gotemcoach86/Geeetech-Spark-E3/Hardware/Geeetech Spark E3 V1.0_Bottom.pdf

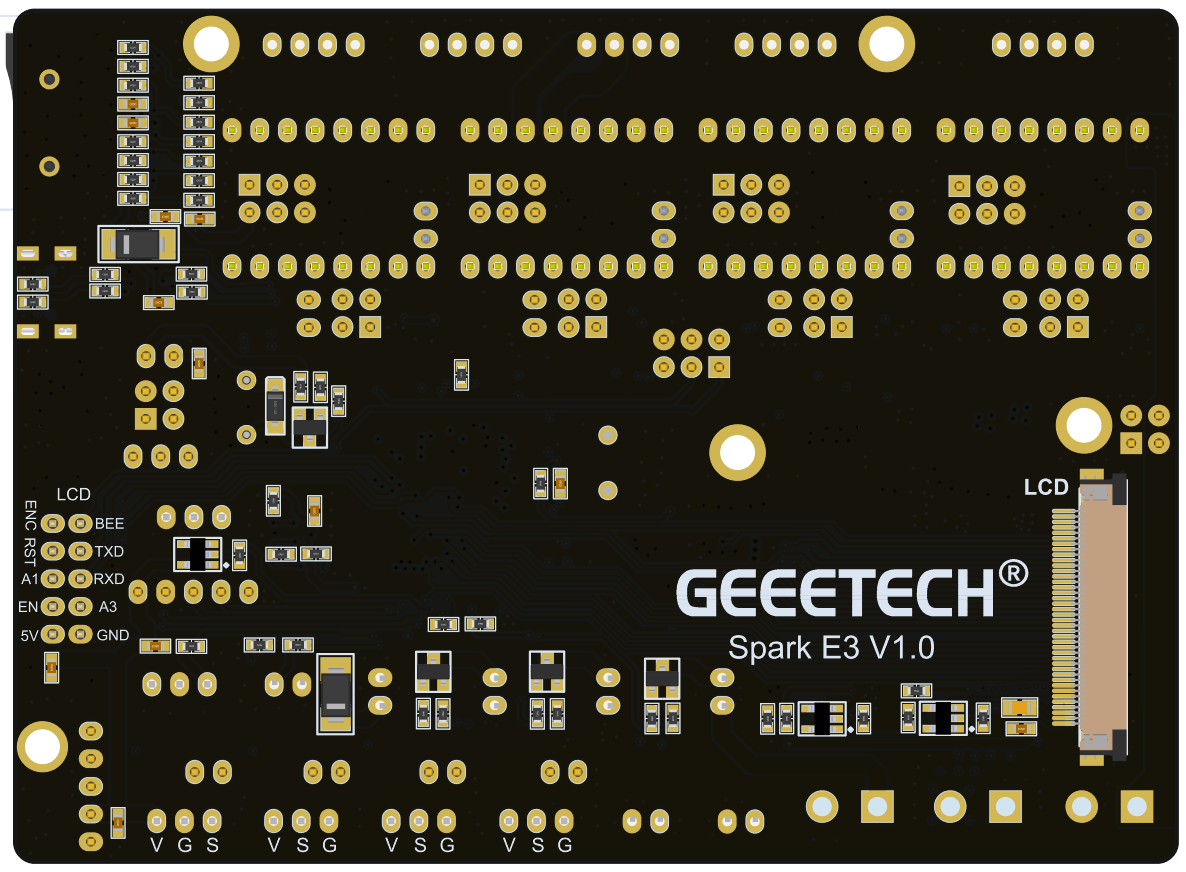
[picture p1: figure]
