gotemcoach86/Geeetech-Spark-E3/Hardware/Geeetech Spark E3 V1.0_Size.pdf

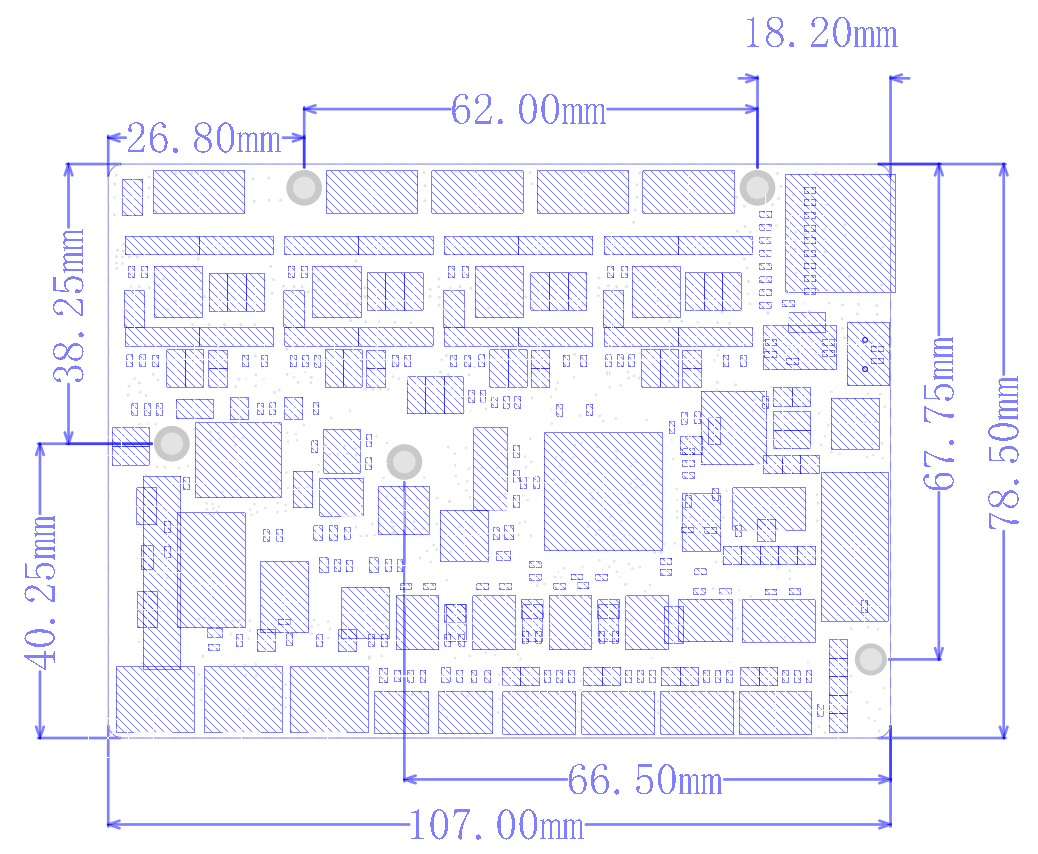
[picture p2: figure]
