gotemcoach86/Geeetech-Spark-E3/Hardware/Geeetech Spark E3 V1.0_Top.pdf

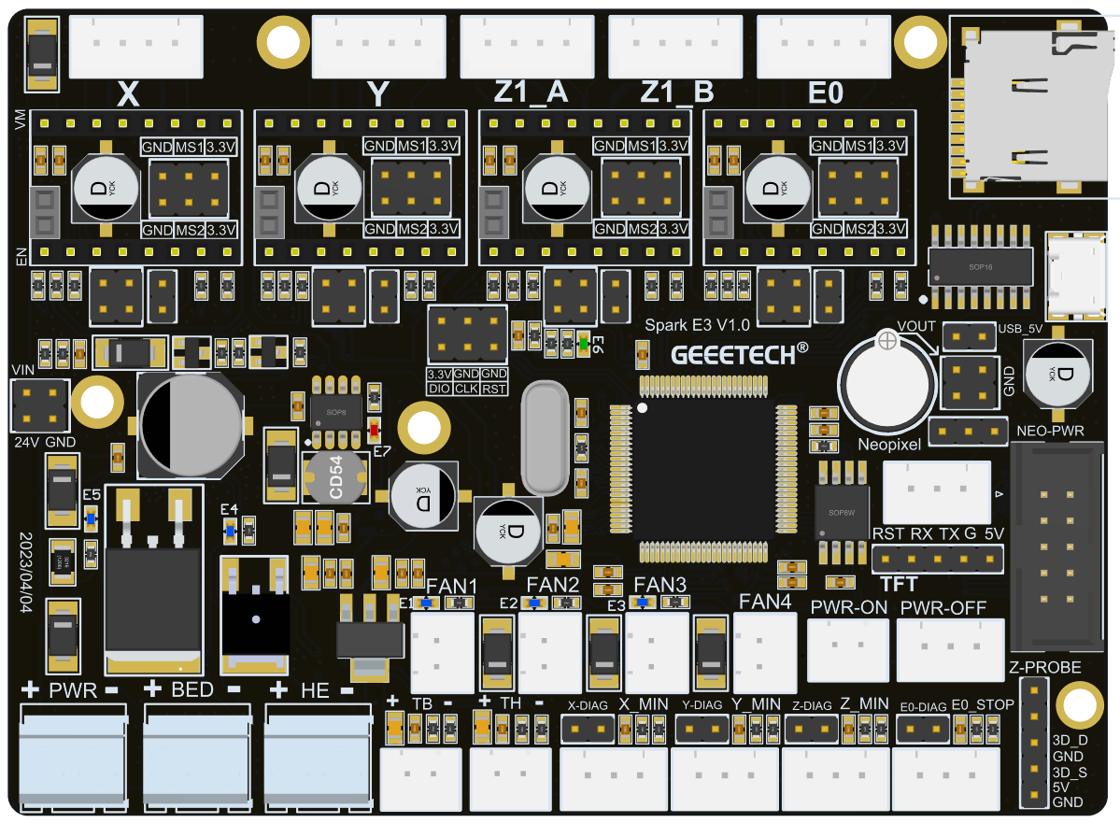
[picture p3: figure]
