gotemcoach86/Geeetech-Spark-E3/Hardware/Geeetech Spark E3 V1.0_Bottom_Designator.pdf

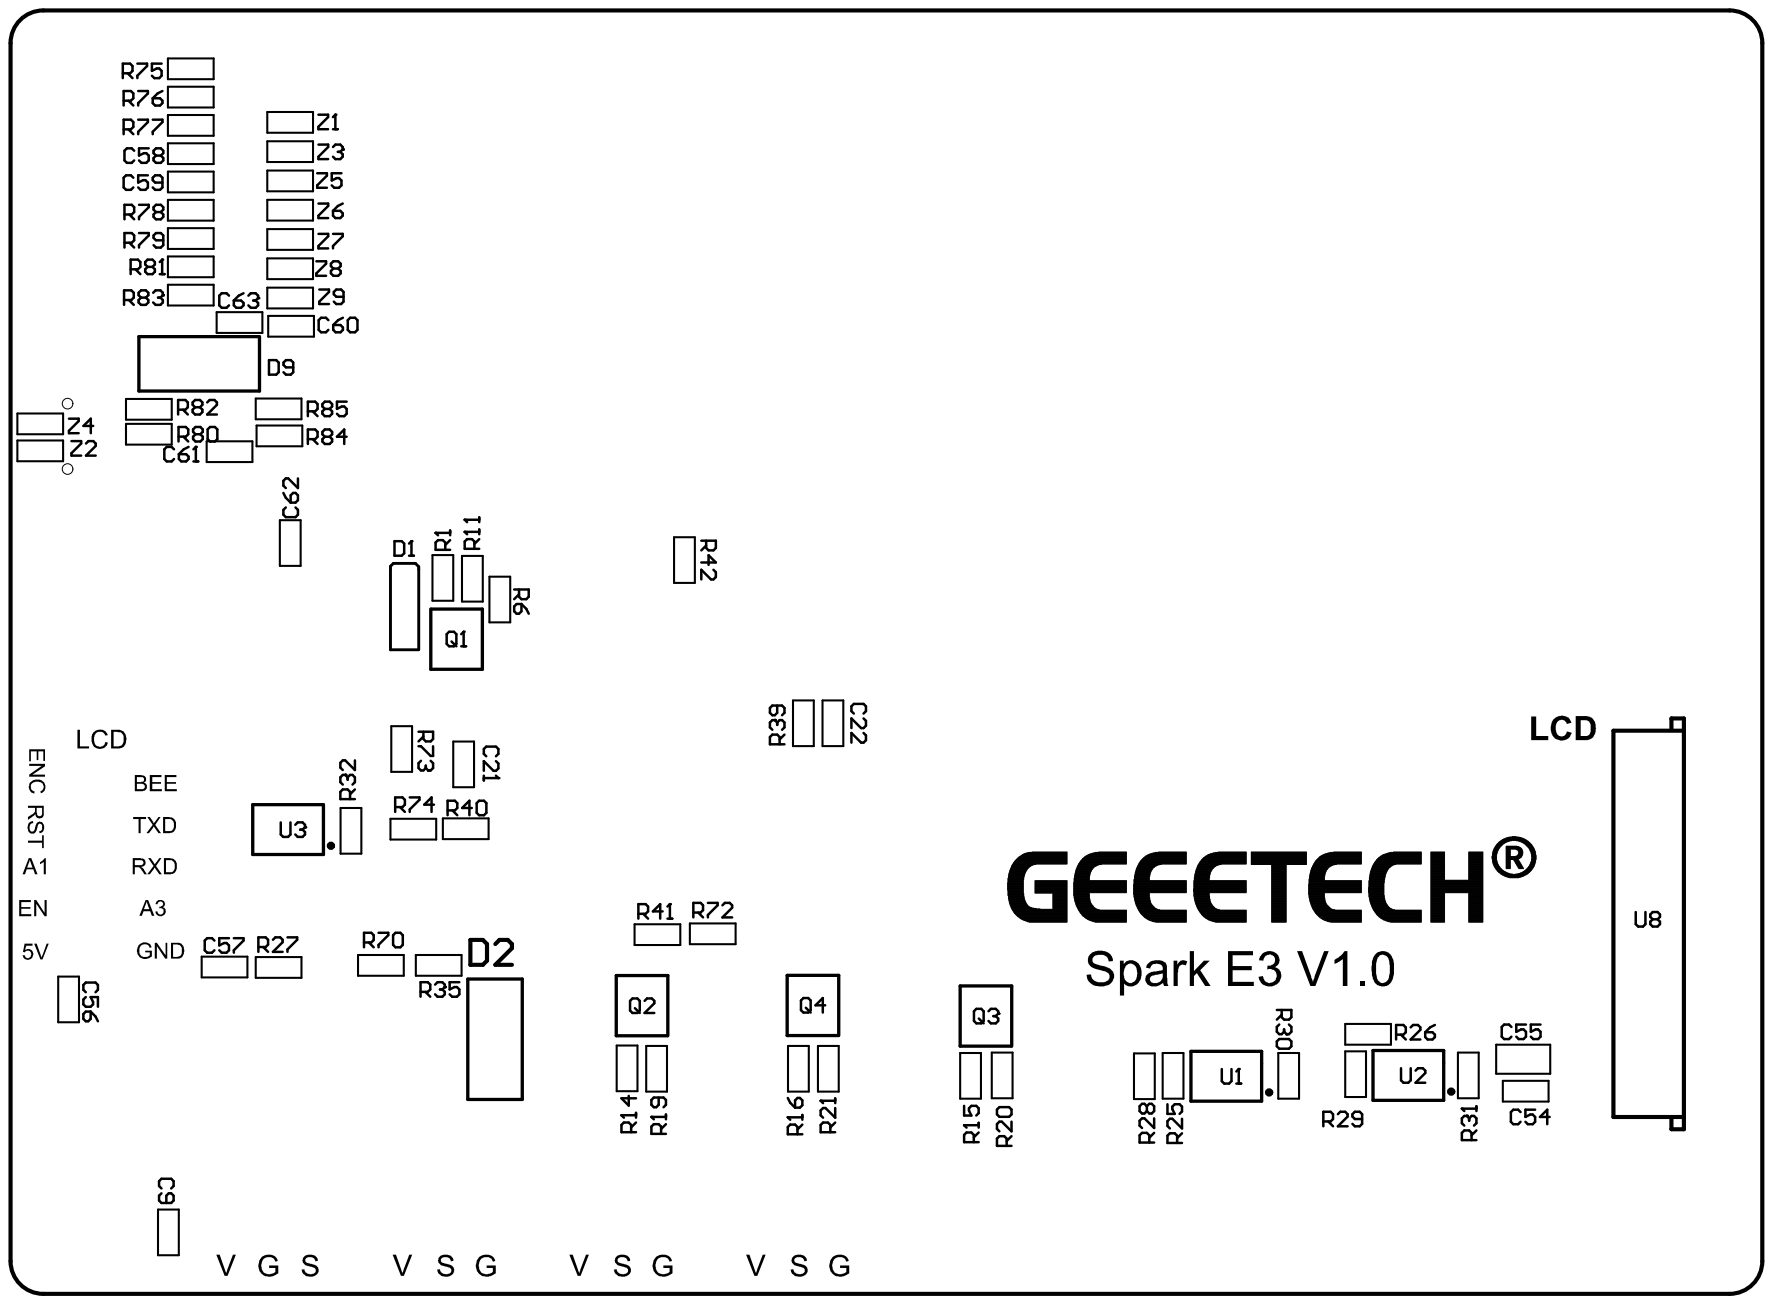
[picture p4: page 1]
