gotemcoach86/Geeetech-Spark-E3/Hardware/Geeetech Spark E3 V1.0_SCH.pdf

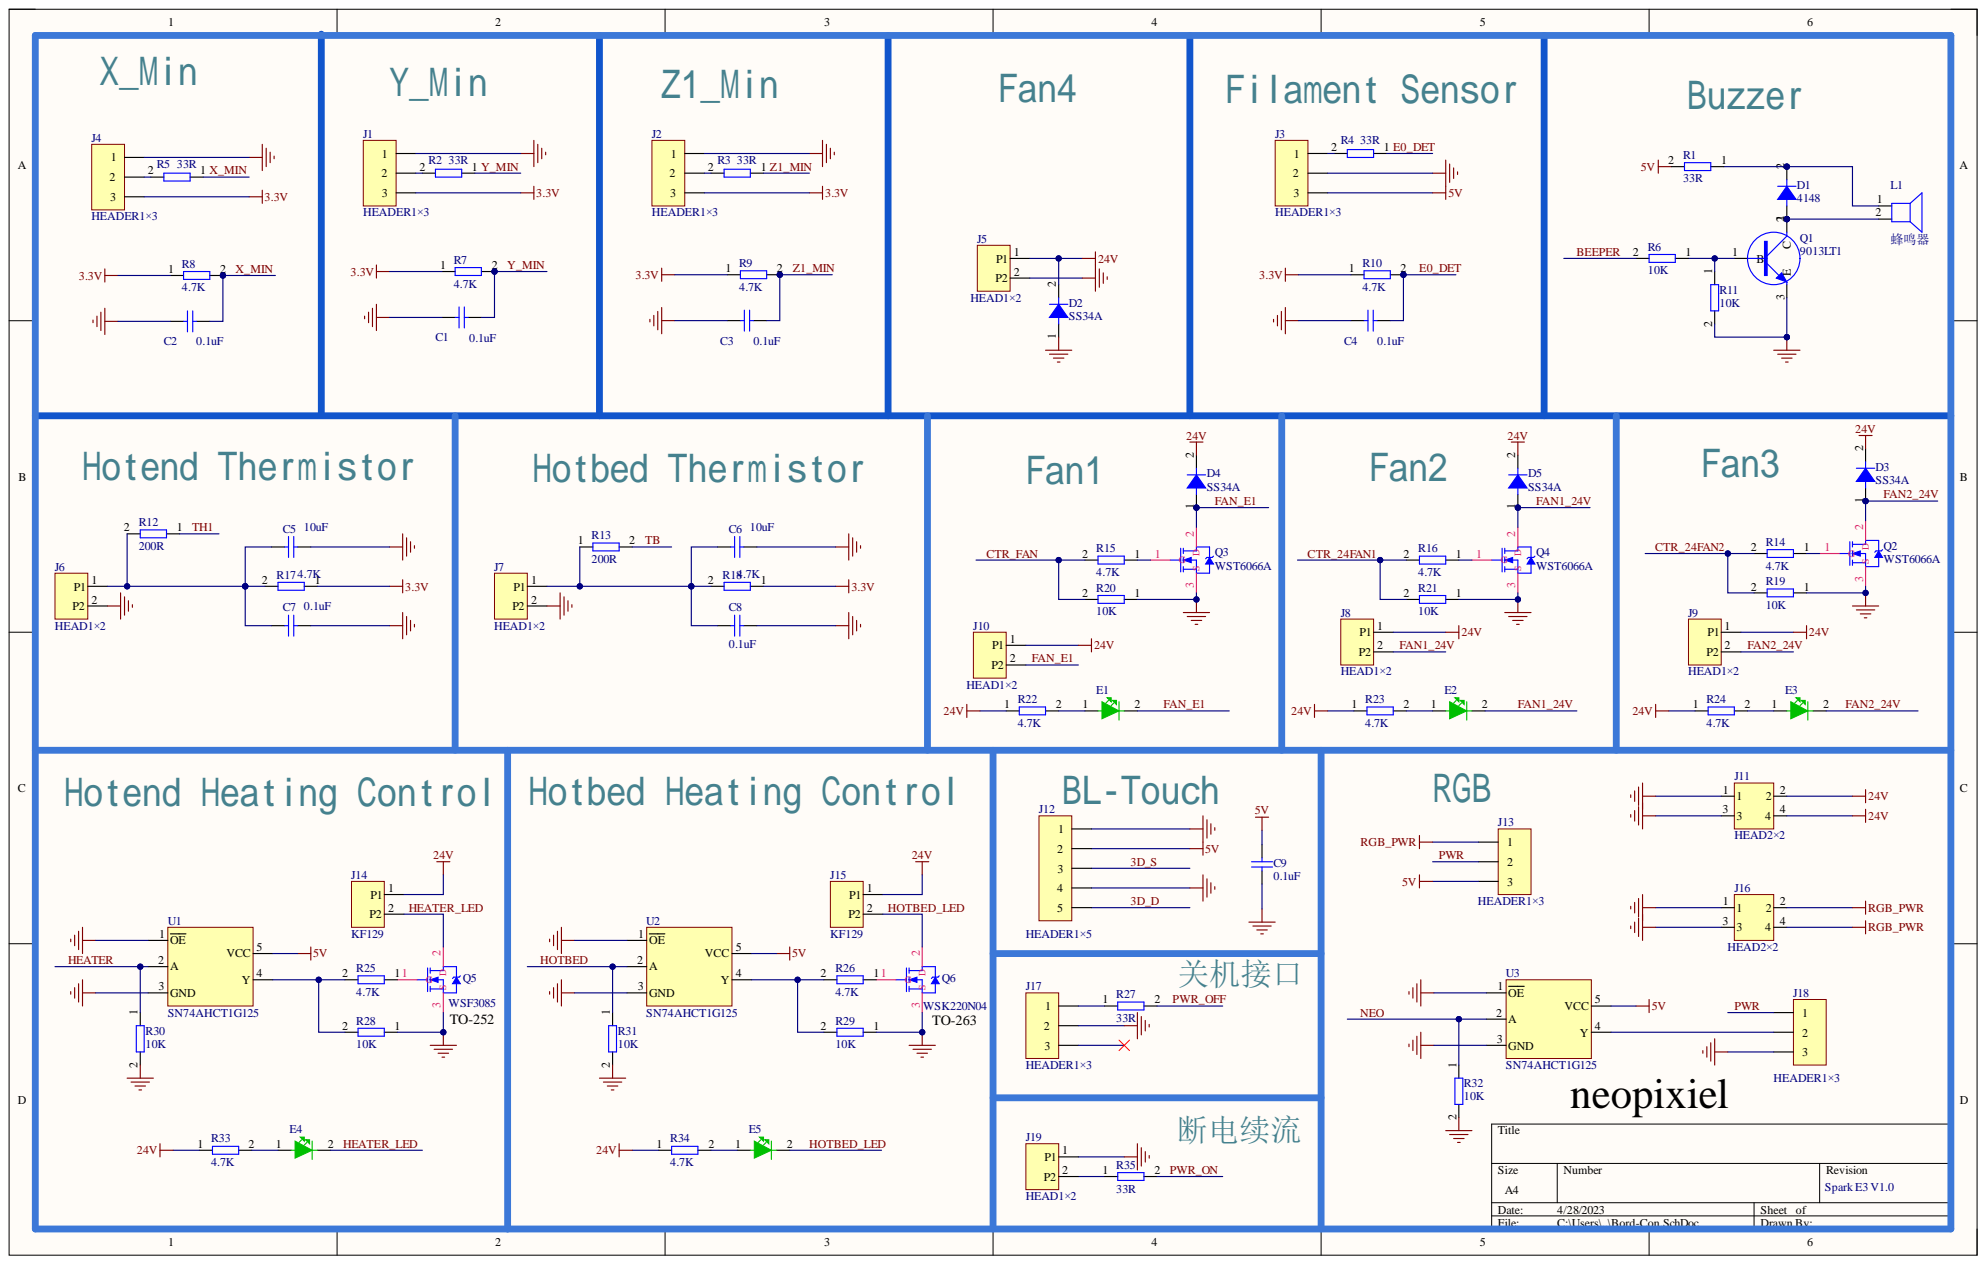
[picture p5: page 1]

Size A4 | Number | Revision Spark E3 V1.0

Date: 4/28/2023 | Sheet of
File: C:\Users\..\Bord-Con.SchDoc | Drawn By:

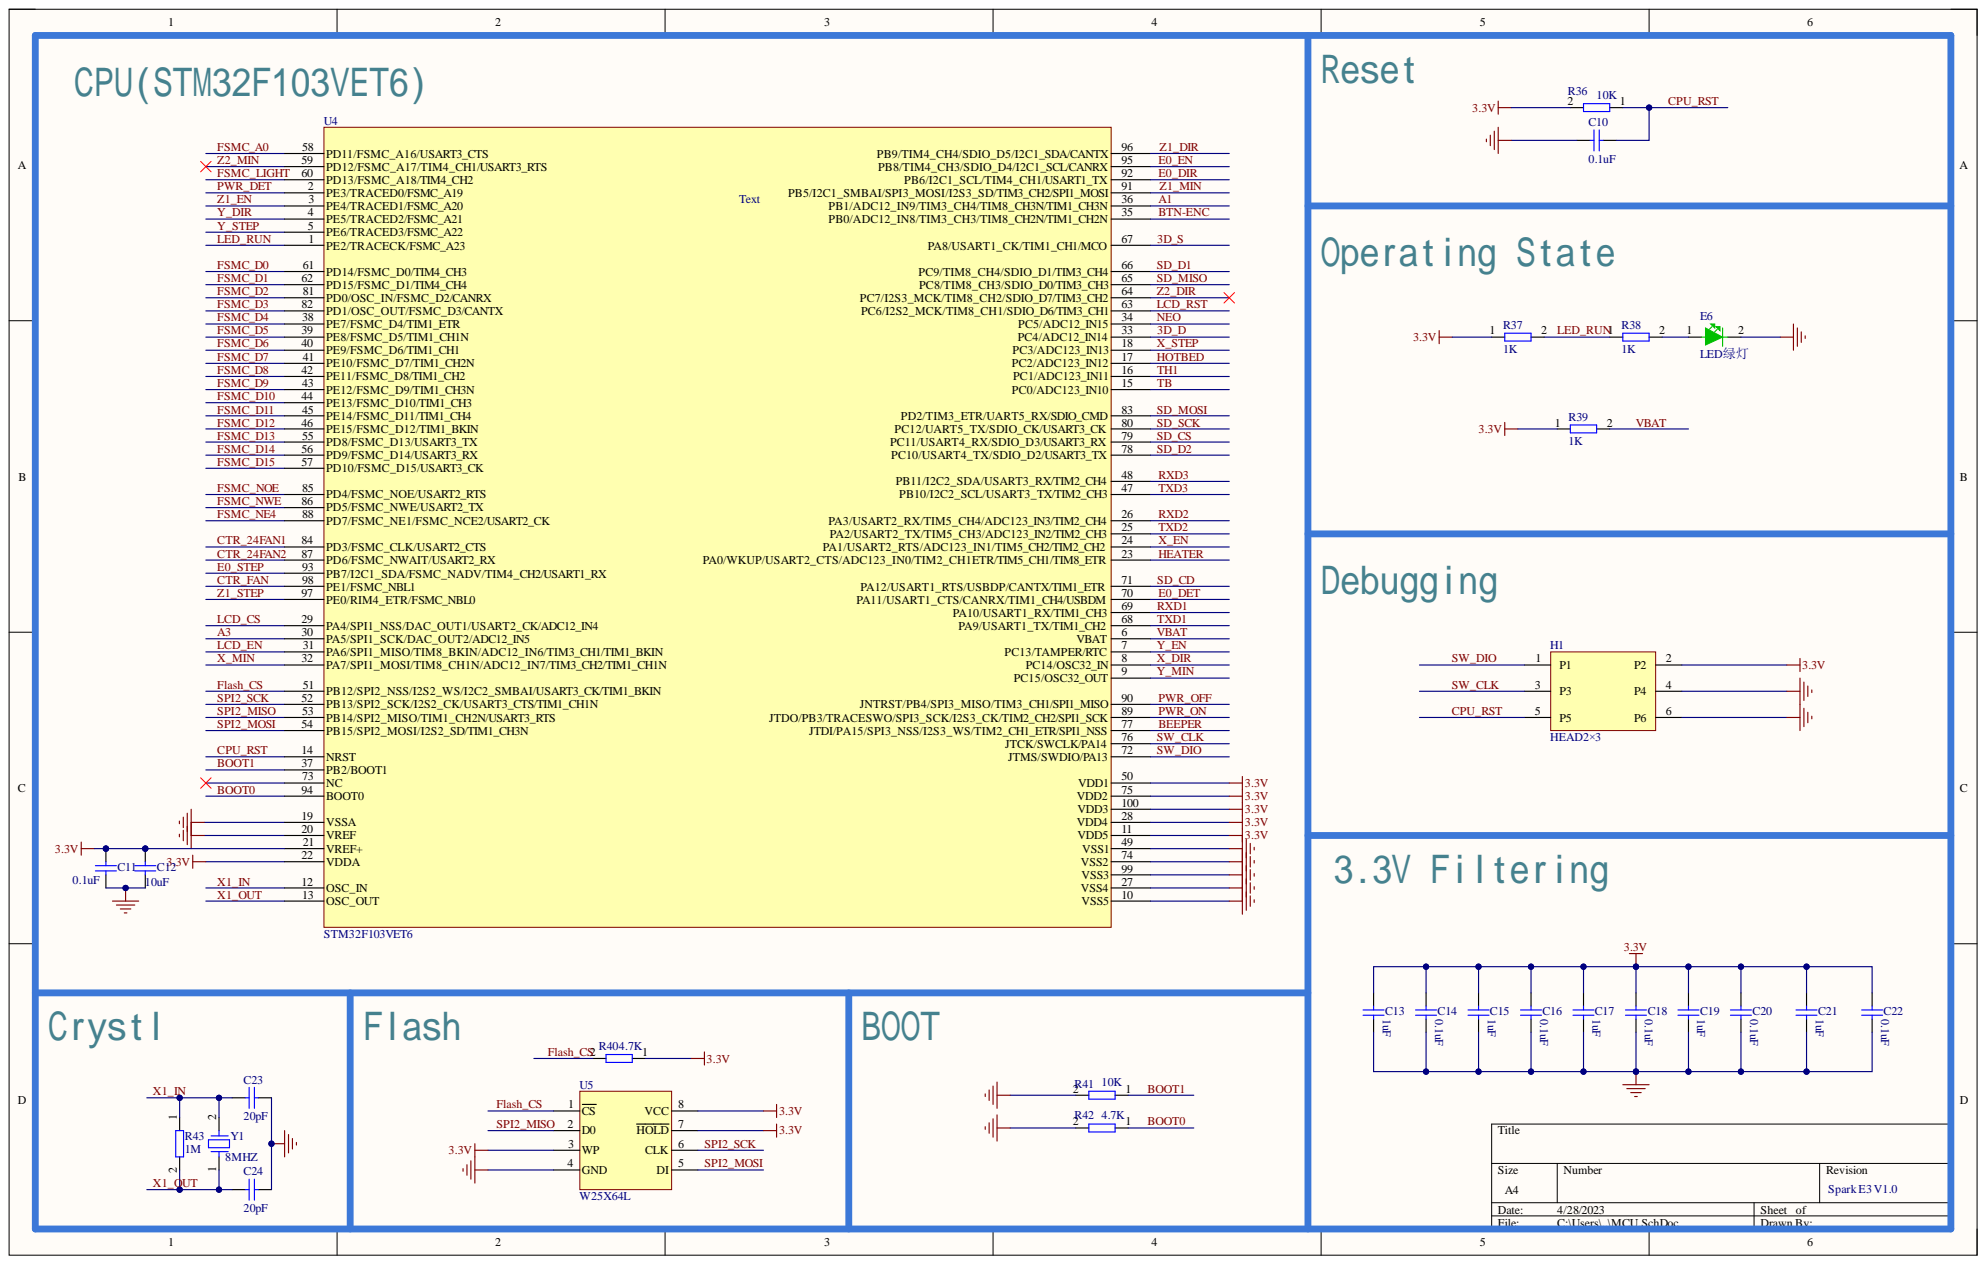
[picture p6: page 2]

Date : 4/2 8 /2 0 2 3 | S h e et o f
File : C:\Users\. .\MCU. S c h D o c | Drawn By :

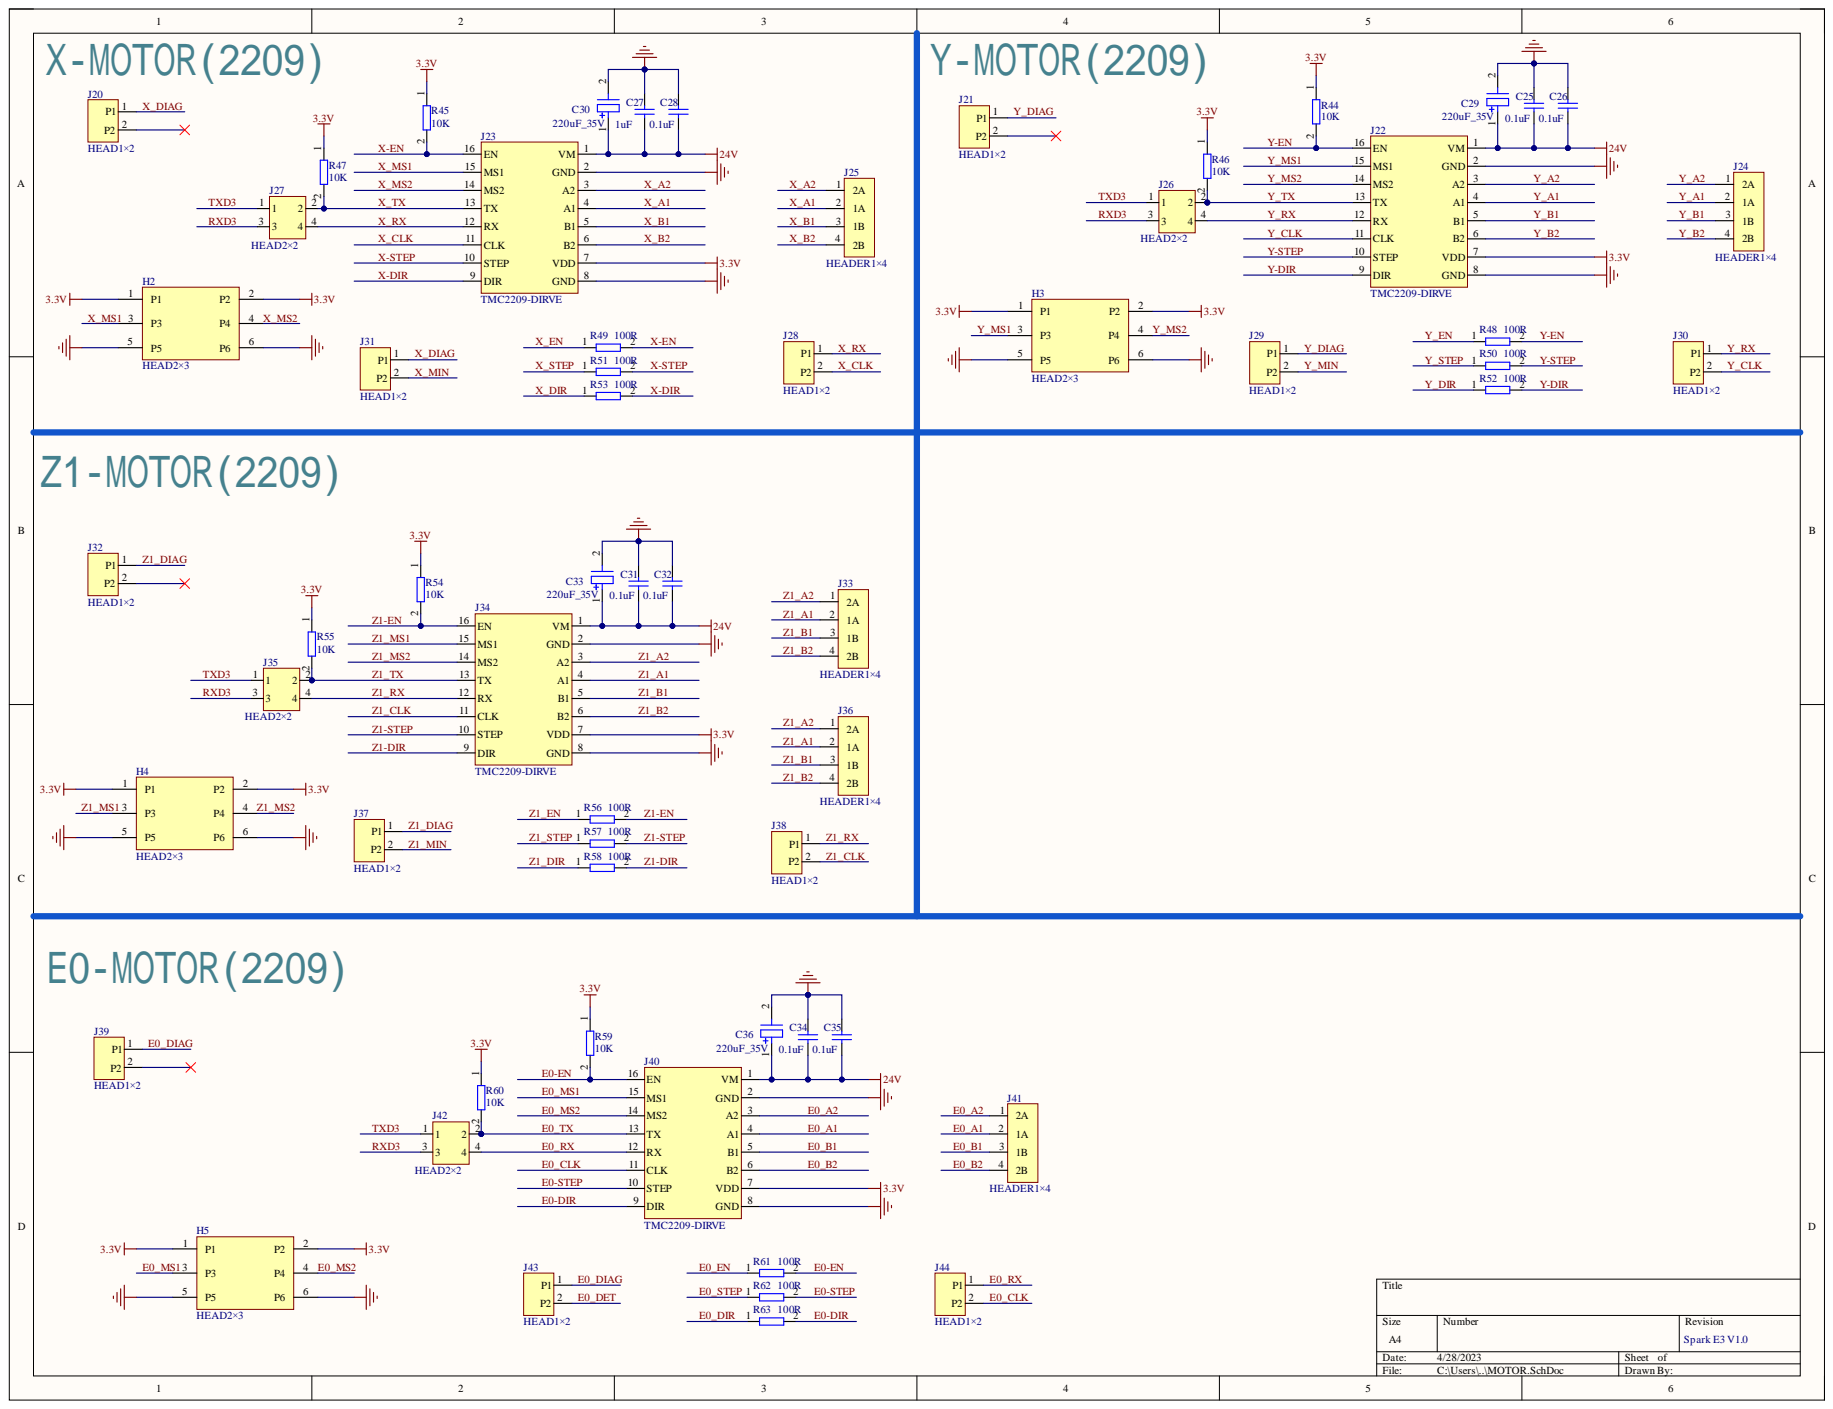
[picture p7: page 3]

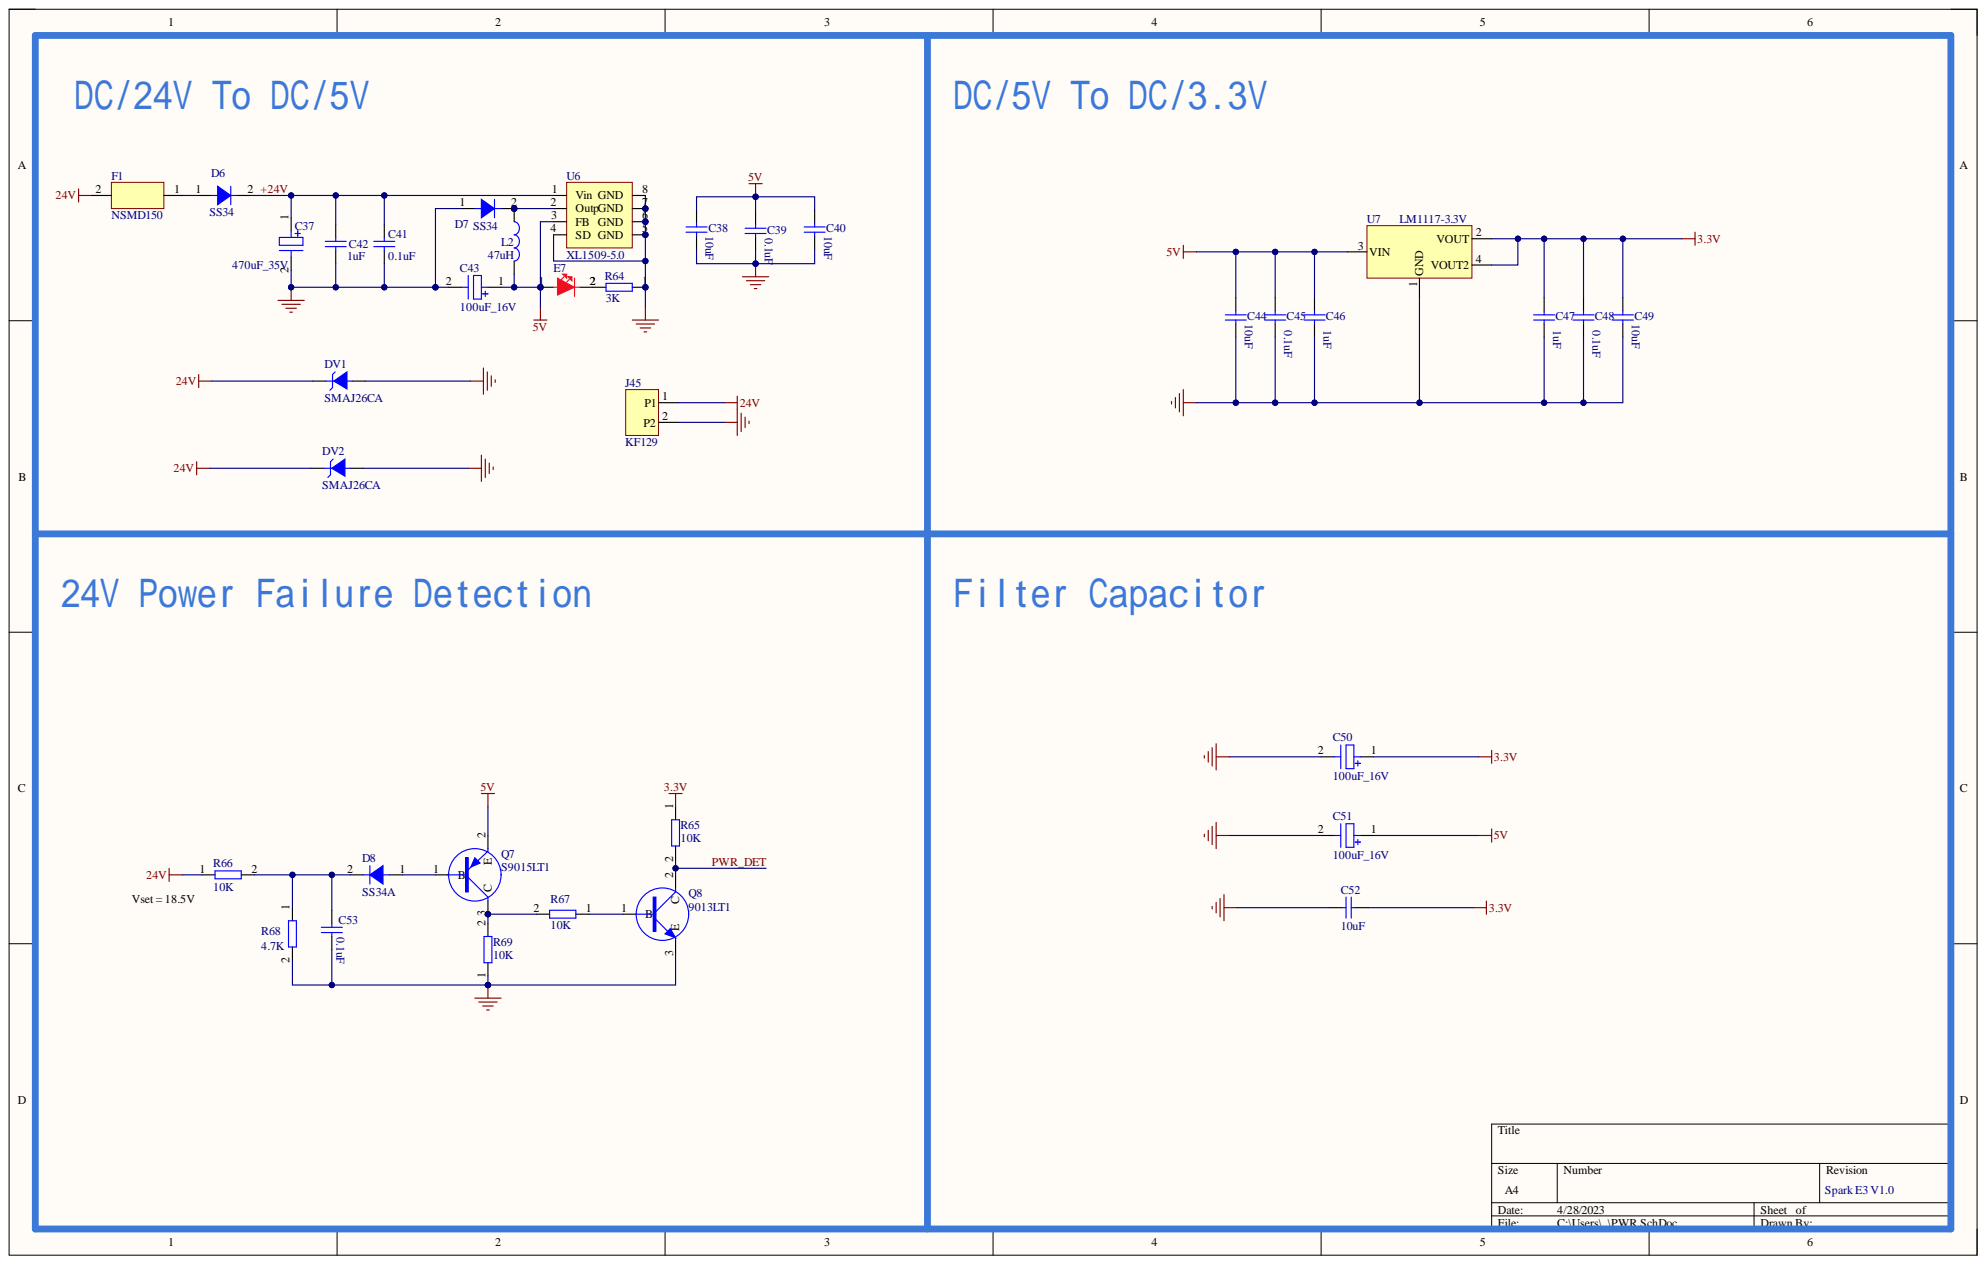
[picture p8: page 4]

Size A4 | Number | Revision Spark E3 V1.0

Date: 4/28/2023 | Sheet of
File: C:\Users\..\PWR.SchDoc | Drawn By:

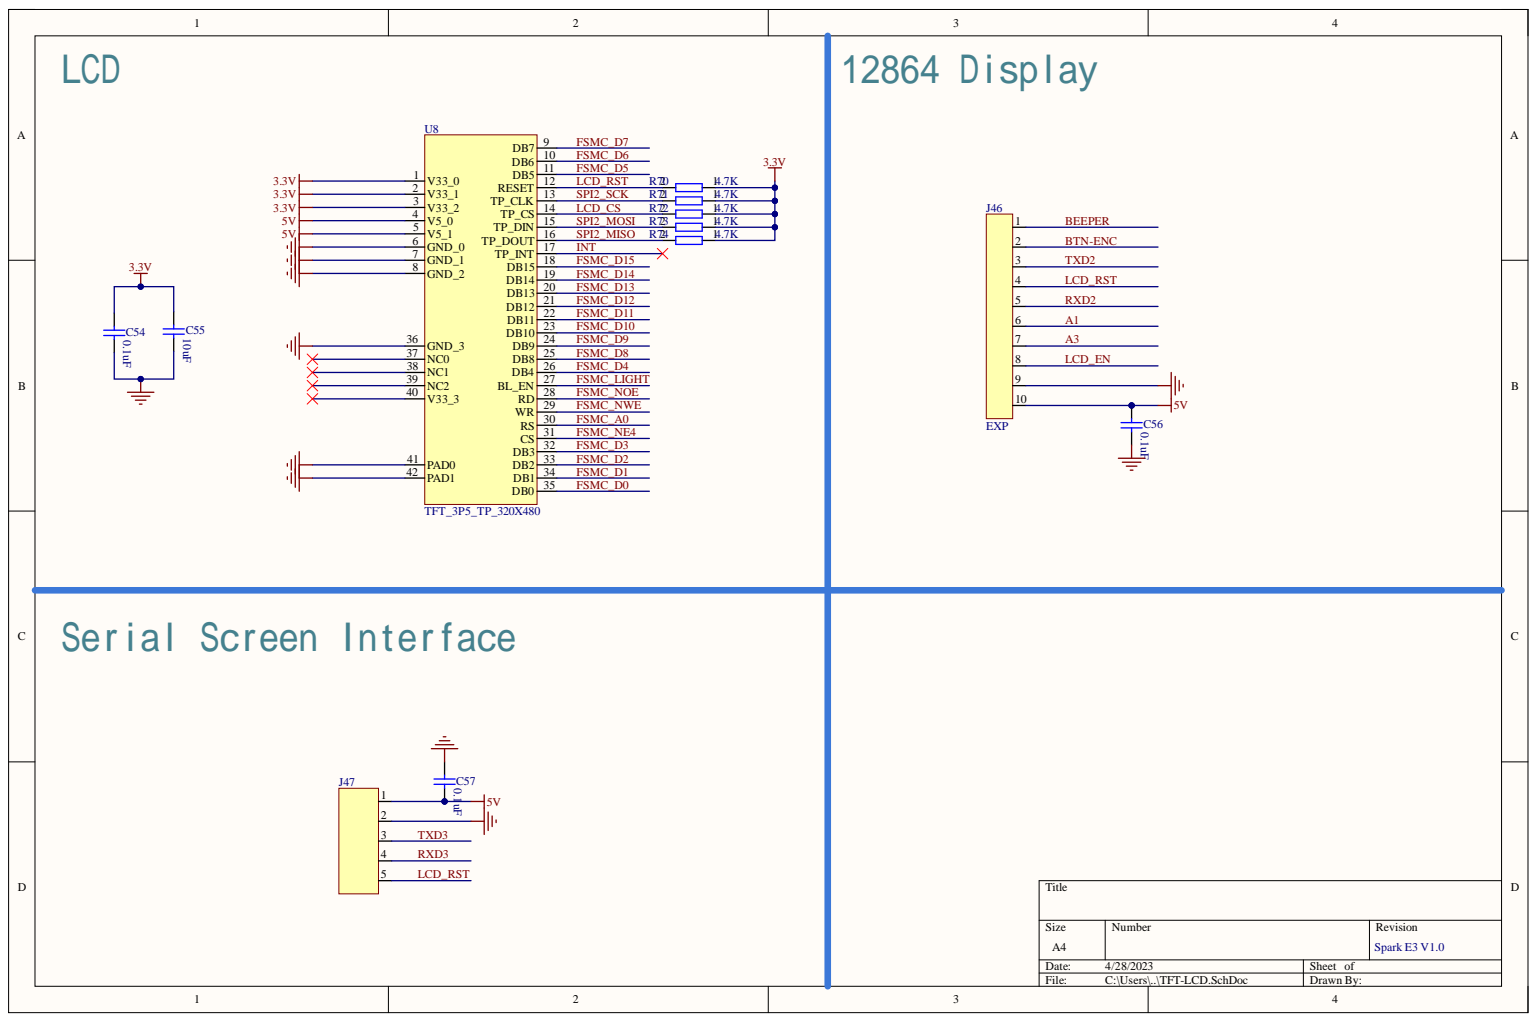
[picture p9: page 5]

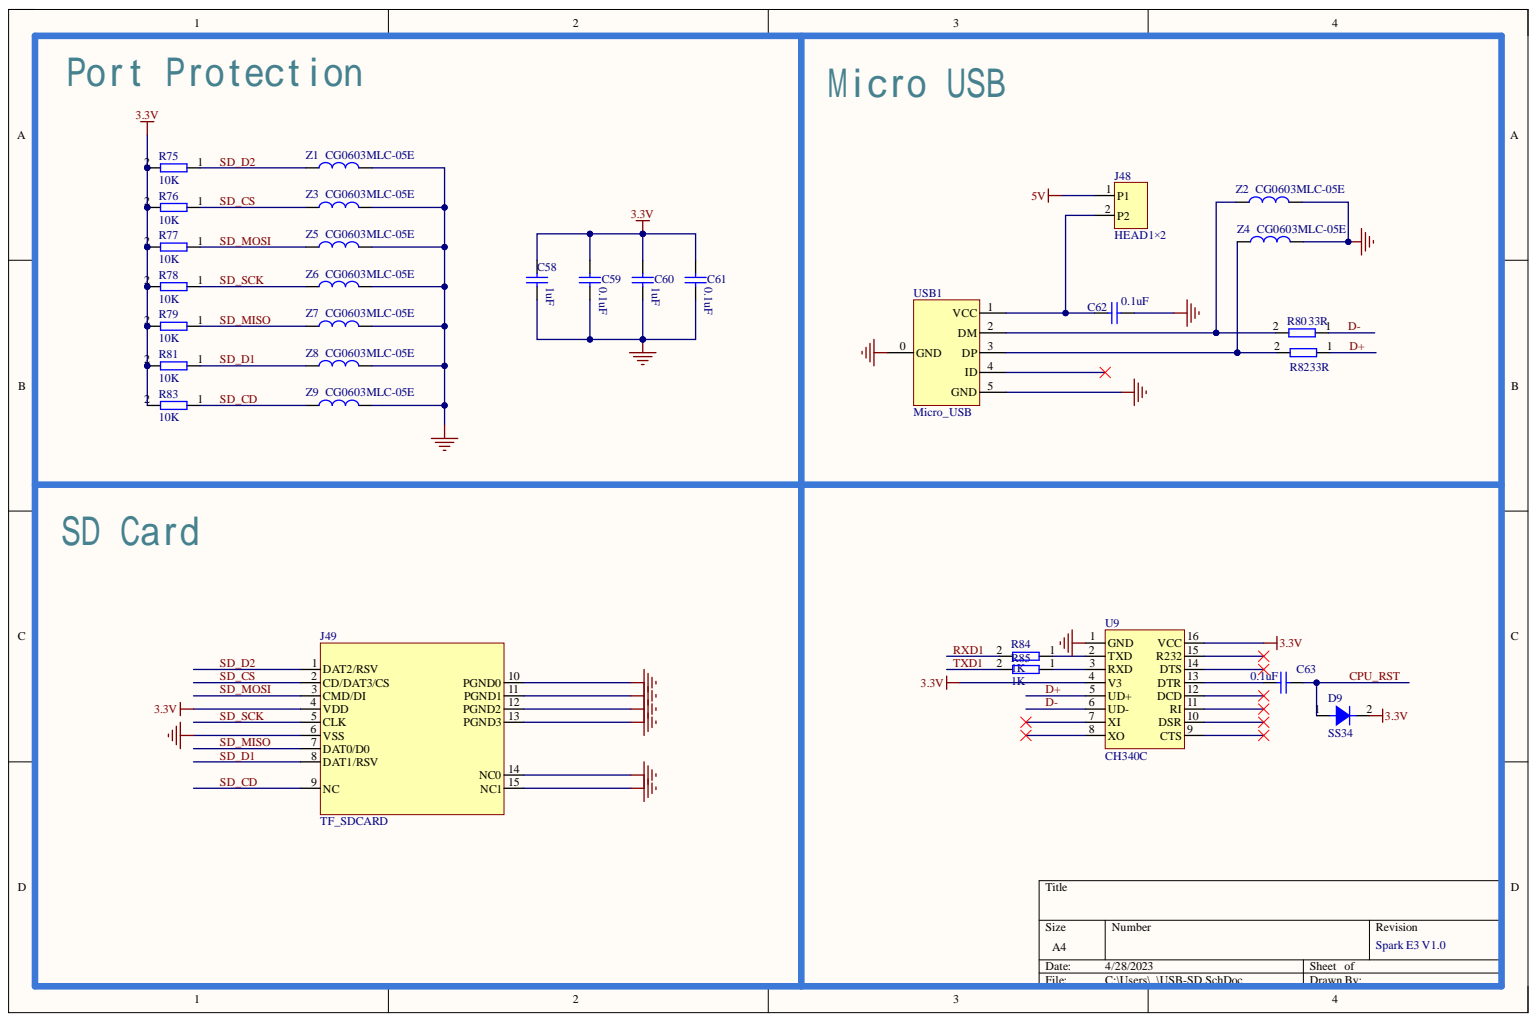
[picture p10: page 6]

Size A4 | Number | Revision Spark E3 V1.0

Date: 4/28/2023 | Sheet of
File: C:\Users\..\USB-SD.SchDoc | Drawn By:
