gotemcoach86/Geeetech-Spark-E3/Hardware/Geeetech Spark E3 V1.0_Top_Designator.pdf

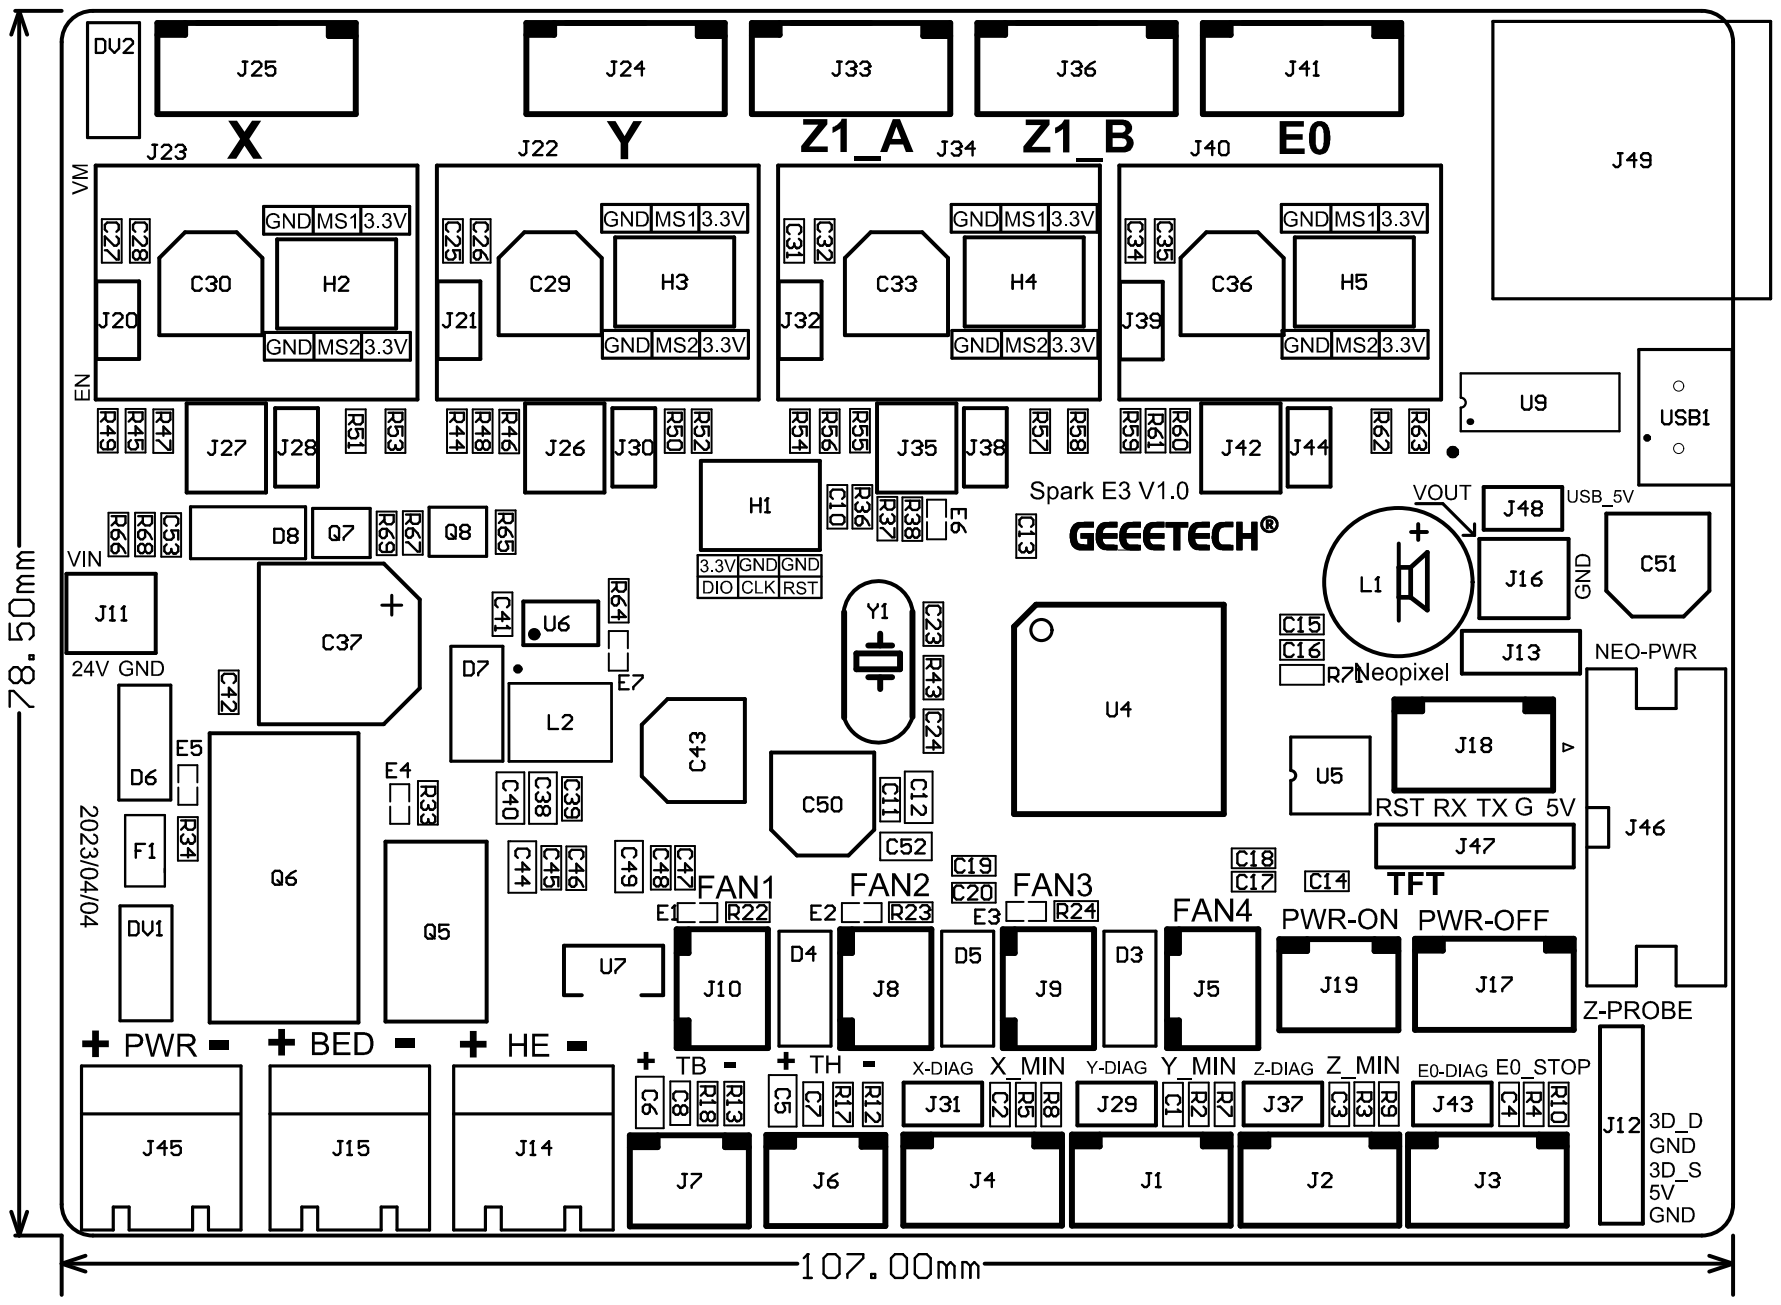
[picture p11: page 1]
