gotemcoach86/Geeetech-Spark-E3/Firmware/Marlin/SparkE3_V1.0_230428/SRC/Marlin-SparkE3-Lcd12864-A4988/Marlin/src/pins/stm32f1/pins_GTM32_SPARK_E2.h

/**
 * Marlin 3D Printer Firmware
 * Copyright (c) 2021 MarlinFirmware [https://github.com/MarlinFirmware/Marlin]
 *
 * Based on Sprinter and grbl.
 * Copyright (c) 2011 Camiel Gubbels / Erik van der Zalm
 *
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
 */
#pragma once

//
// Release PB4 (Y_ENABLE_PIN) from JTAG NRST role
//
#define DISABLE_JTAG
//
// Release PB3 PB4 PA15
//
#define DISABLE_DEBUG

#define BOARD_INFO_NAME			"Spark E3 V1.0"
#define CUSTOMER_FW_VERSION "1.0.0"

/**
 * MKS Robin Nano board common pin assignments
 */
#if HOTENDS > 2 || E_STEPPERS > 2
  #error "GTM32 Spark E2 boards support up to 2 hotends / E steppers."
#endif

#define BOARD_NO_NATIVE_USB

// Avoid conflict with TIMER_SERVO when using the STM32 HAL
#define TEMP_TIMER  5

//
// EEPROM
//
#if ENABLED(SRAM_EEPROM_EMULATION)
  #undef NO_EEPROM_SELECTED
#endif
#if EITHER(NO_EEPROM_SELECTED, FLASH_EEPROM_EMULATION)
  #define FLASH_EEPROM_EMULATION
  #define EEPROM_PAGE_SIZE     (0x800U) // 2K
  #define EEPROM_START_ADDRESS (0x8000000UL + (STM32_FLASH_SIZE) * 1024UL - (EEPROM_PAGE_SIZE) * 2UL)
  #define MARLIN_EEPROM_SIZE    EEPROM_PAGE_SIZE  // 2K
#endif

//
// Z Probe (when not Z_MIN_PIN)
//
#define Z_MIN_PROBE_PIN                     PC4

#define LED_PIN                           	PE2

#define SPI_DEVICE                          2

//
// Servos
//
#define SERVO0_PIN                          PA8   // Enable BLTOUCH

//
// Limit Switches
//
#define X_STOP_PIN                          PA7
#define Y_STOP_PIN                          PC15
#define Z_MIN_PIN                           PB5
#define Z_MAX_PIN                           PD12

//
// Steppers
//
#define X_ENABLE_PIN                        PA1
#define X_STEP_PIN                          PC3
#define X_DIR_PIN                           PC14

#define Y_ENABLE_PIN                        PC13
#define Y_STEP_PIN                          PE6
#define Y_DIR_PIN                           PE5

#define Z_ENABLE_PIN                        PE4
#define Z_STEP_PIN                          PE0
#define Z_DIR_PIN                           PB9


#define E0_ENABLE_PIN                       PB8
#define E0_STEP_PIN                         PB7
#define E0_DIR_PIN                          PB6

//
// Temperature Sensors
//
#define TEMP_0_PIN                          PC1   // TH1
#define TEMP_1_PIN                          -1    // TH2
#define TEMP_BED_PIN                        PC0   // TB1

//
// Heaters / Fans
//
#ifndef HEATER_0_PIN
  #define HEATER_0_PIN                      PA0
#endif
#ifndef FAN_PIN
  #define FAN_PIN                           PE1 // FAN
  #define FAN_SOFT_PWM
#endif
#ifndef HEATER_BED_PIN
  #define HEATER_BED_PIN                    PC2
#endif

#if HOTENDS == 1 && DISABLED(HEATERS_PARALLEL)
  #ifndef FAN1_PIN
    #define FAN1_PIN                        PD3 // 24V FAN1 CONTL
    #define FAN1_SOFT_PWM
  #endif
  #ifndef FAN2_PIN
    #define FAN2_PIN                        PD6 // 24V FAN2 CONTL
    #define FAN2_SOFT_PWM
  #endif
#elif !defined(HEATER_1_PIN)
  #define HEATER_1_PIN                      -1 
#endif

//
// Power Supply Control
//
#if ENABLED(MKS_PWC)
  #if ENABLED(TFT_LVGL_UI)
    #if ENABLED(PSU_CONTROL)
      #error "PSU_CONTROL is incompatible with MKS_PWC plus TFT_LVGL_UI."
    #endif
    #undef MKS_PWC
    #define SUICIDE_PIN                     PB2
    #define SUICIDE_PIN_STATE               LOW
  #else
    #define PS_ON_PIN                       PB3 // PW_OFF
  #endif
  #define KILL_PIN                          PB4
  #define KILL_PIN_STATE                    HIGH
#endif

//
// Misc. Functions
//
#if HAS_TFT_LVGL_UI
  #define MT_DET_1_PIN                      PA11
  #define MT_DET_2_PIN                      PE6
  #define MT_DET_PIN_STATE                  LOW

  #define WIFI_IO0_PIN                      -1
  #define WIFI_IO1_PIN                      -1
  #define WIFI_RESET_PIN                    -1 
#else
  #define POWER_LOSS_PIN                 	PE3   // PWR_DET
  #define POWER_LOSS_STATE       			LOW 

  #define PS_ON_PIN                         PB3   // PWR_ON
  #define PS_OFF_PIN						PB4   // PWR_OFF

  #define FIL_RUNOUT_PIN                    PA11
  #define FIL_RUNOUT2_PIN                   PE6
#endif

//
// SD Card
//
#ifndef SDCARD_CONNECTION
  #define SDCARD_CONNECTION              ONBOARD
#endif

#define SDIO_SUPPORT
#define SDIO_CLOCK                       4500000  // 4.5 MHz
#define SD_DETECT_PIN                       PA12
#define ONBOARD_SD_CS_PIN                   PC11

//
// LCD / Controller
//
#define BEEPER_PIN                          PA15

//
// TFT with FSMC interface
//
#if HAS_FSMC_TFT
  /**
   * Note: MKS Robin TFT screens use various TFT controllers.
   * If the screen stays white, disable 'TFT_RESET_PIN'
   * to let the bootloader init the screen.
   */
  #define TFT_RESET_PIN                     PC6   // FSMC_RST
  #define TFT_BACKLIGHT_PIN                 PD13

  #define DOGLCD_MOSI                       -1    // Prevent auto-define by Conditionals_post.h
  #define DOGLCD_SCK                        -1

  #define TOUCH_CS_PIN                      PA4   // SPI2_NSS
  #define TOUCH_SCK_PIN                     PB13  // SPI2_SCK
  #define TOUCH_MISO_PIN                    PB14  // SPI2_MISO
  #define TOUCH_MOSI_PIN                    PB15  // SPI2_MOSI

  #define LCD_USE_DMA_FSMC                        // Use DMA transfers to send data to the TFT
  #define FSMC_CS_PIN                       PD7
  #define FSMC_RS_PIN                       PD11
  #define FSMC_DMA_DEV                      DMA2
  #define FSMC_DMA_CHANNEL               DMA_CH5

  #define TFT_CS_PIN                 FSMC_CS_PIN
  #define TFT_RS_PIN                 FSMC_RS_PIN

  #define TOUCH_BUTTONS_HW_SPI
  #define TOUCH_BUTTONS_HW_SPI_DEVICE          2

  #define TFT_BUFFER_SIZE                  14400
#endif

#define HAS_SPI_FLASH                          1
#if HAS_SPI_FLASH
  #define SPI_FLASH_SIZE               0x1000000  // 16MB
  #define SPI_FLASH_CS_PIN                  PB12
  #define SPI_FLASH_MOSI_PIN                PB15
  #define SPI_FLASH_MISO_PIN                PB14
  #define SPI_FLASH_SCK_PIN                 PB13
#endif

#if ENABLED(CR10_STOCKDISPLAY)					
  #define BTN_ENC							PB0
  #define BTN_EN1            				PA2
  #define BTN_EN2            				PA3
  #define LCD_PINS_RS						PA5  	// CS
  #define LCD_PINS_ENABLE					PA6  	// DAT
  #define LCD_PINS_D4						PB1  	// CLK
#endif
