gotemcoach86/Geeetech-Spark-E3/Firmware/Marlin/SparkE3_V1.0_230428/SRC/Bootloader/Src/main.c

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
/* Includes ------------------------------------------------------------------*/
#include "main.h"
#include "fatfs.h"
#include "sdio.h"
#include "usart.h"
#include "gpio.h"
#include "fsmc.h"

/* USER CODE BEGIN Includes */
#include "menu.h"
#include "common.h"
#include "flash_if.h"
#include "bsp_lcd.h"
#include "command.h"
/* USER CODE END Includes */

/* USER CODE BEGIN PTD */
#define IAP_CHECK_TIME			1000
/* USER CODE END PTD */


/* USER CODE BEGIN PV */
uint8_t usart_recv_data;

extern pFunction JumpToApplication;
extern uint32_t JumpAddress;

const char DownloadFile[] = "GTM32Source.bin";
const char BackupFile[] = "GTM32Source.bk";

extern void HAL_SRAM_MspDeInit(SRAM_HandleTypeDef* sramHandle);
/* USER CODE END PV */

void SystemClock_Config(void);
/* USER CODE BEGIN PFP */
extern void SerialDownload(void);
/* USER CODE END PFP */

/* USER CODE BEGIN 0 */
#define TFT_LCD_ENABLE	
/* USER CODE END 0 */

/**
  * @brief  The application entry point.
  * @retval int
  */
int main(void)
{
    /* MCU Configuration--------------------------------------------------------*/

    /* Reset of all peripherals, Initializes the Flash interface and the Systick. */
    HAL_Init();

    /* Configure the system clock */
    SystemClock_Config();

    /* Initialize all configured peripherals */
    MX_GPIO_Init();
    MX_FSMC_Init();
    MX_SDIO_SD_Init();
    MX_FATFS_Init();
    MX_USART1_UART_Init();
    /* USER CODE BEGIN 2 */
	Serial_PutString(BOOT_FW_VERSION);
    // SDCard update check first
    if(FR_OK == f_mount_status && f_open(&SDFile, DownloadFile, FA_READ) == FR_OK) {
        BSP_LCD_Init();
        FLASH_If_Init();
        LCD_DispString_EN(10, 280, BOOT_FW_VERSION, BLACK, GRAY, USB_FONT_24);
        LCD_DispString_EN(10, 100, "SDCard Upgrade ... ", BLACK, YELLOW, USB_FONT_24);
        Serial_PutString("\r\nSDCard Upgrade ...  \r\n");
        if(COMMAND_DOWNLOAD() != DOWNLOAD_OK) {
            LCD_DispString_EN(10, 130, "Flash download error", BLACK, RED, USB_FONT_24);
            Serial_PutString("Flash download error \r\n");
        } else {
            LCD_DispString_EN(10, 130, "Download done", BLACK, GREEN, USB_FONT_24);
            Serial_PutString("\r\nDownload done \r\n");
            f_close(&SDFile);
			#if 0
            if(f_rename(DownloadFile, BackupFile)) { //if(FR_OK == f_unlink(DownloadFile))
                HAL_Delay(200);
                HAL_NVIC_SystemReset();
            }
			#endif
        }
    } else { // Without SDCard update, check usart update.
        /* Clean the input path */
        __HAL_UART_FLUSH_DRREGISTER(&UartHandle);

        /* Receive key */
        if(HAL_OK == HAL_UART_Receive(&UartHandle, &usart_recv_data, 1, IAP_CHECK_TIME)) {
            if(usart_recv_data == 'c' || usart_recv_data == 'C') {
                BSP_LCD_Init();
                FLASH_If_Init();
                LCD_DispString_EN(10, 290, BOOT_FW_VERSION, BLACK, GRAY, USB_FONT_24);
                LCD_DispString_EN(10, 100, "USART Update ...", BLACK, YELLOW, USB_FONT_24);
				Serial_PutString("\r\nUSART Update ... \r\n");
                SerialDownload(); //Main_Menu ();
            }
        }
    }

    /*** Close all of interrupts before jump app */
    __disable_irq();

    /* Test if user code is programmed starting from address "APPLICATION_ADDRESS" */
    if(((*(__IO uint32_t*)APPLICATION_ADDRESS) & 0x2FFE0000) == 0x20000000) {
        /* Jump to user application */
        JumpAddress = *(__IO uint32_t*)(APPLICATION_ADDRESS + 4);
        JumpToApplication = (pFunction) JumpAddress;
        /* Initialize user application's Stack Pointer */
        __set_MSP(*(__IO uint32_t*) APPLICATION_ADDRESS);
        JumpToApplication();
    }
    /* USER CODE END 2 */

    /* Infinite loop */
    /* USER CODE BEGIN WHILE */
    while(1) {
        /* USER CODE END WHILE */

        /* USER CODE BEGIN 3 */
    }
    /* USER CODE END 3 */
}

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
