gotemcoach86/Geeetech-Spark-E3/Firmware/Marlin/SparkE3_V1.0_230428/SRC/Bootloader/Inc/main.h

#define BOOT_FW_VERSION			"Bootloader Version: 1.0.9"			
#define FALSE 0
#define TRUE 1
#define UartHandle  huart1
#define FLASH_SIZE                         ((uint32_t)0x80000)  /* 128 KBytes */
#define IAP_SIZE                           ((uint32_t)0x7000)   /* 32Kbytes as IAP size */
#define SDIO_CD_Pin GPIO_PIN_12
#define SDIO_CD_GPIO_Port GPIOA
#define FSMC_LIGHT_Pin GPIO_PIN_13
#define FSMC_LIGHT_GPIO_Port GPIOD
#define HEATER_0_Pin GPIO_PIN_9
#define HEATER_0_GPIO_Port GPIOB
#define HEATER_BED_Pin GPIO_PIN_0
#define HEATER_BED_GPIO_Port GPIOE
#define FAN_Pin			GPIO_PIN_1
#define FAN_GPIO_Port	GPIOE
#define FAN1_24V_Pin		GPIO_PIN_3
#define FAN1_24V_GPIO_Port	GPIOD
#define FAN2_24V_Pin		GPIO_PIN_6
#define FAN2_24V_GPIO_Port	GPIOD
