gotemcoach86/Geeetech-Spark-E3/Firmware/Marlin/SparkE3_V1.0_230428/SRC/Bootloader/Src/command.c

/**
 ******************************************************************************
 * @file    Src/command.c
 * @author  MCD Application Team
 * @version V1.0.0
 * @date    4-April-2016
 * @brief   This file provides all the IAP command functions.
 ******************************************************************************
 * @attention
 *
 * <h2><center>&copy; COPYRIGHT(c) 2016 STMicroelectronics</center></h2>
 *
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
 ******************************************************************************
 */

/** @addtogroup STM32L4xx_IAP_Main
 * @{
 */

/* Includes ------------------------------------------------------------------*/
#include "command.h"
#include "main.h"
#include "flash_if.h"
#include "fatfs.h"
#include "bsp_lcd.h"
/** @addtogroup USBH_USER
 * @{
 */

/* External variables --------------------------------------------------------*/
/* Private typedef -----------------------------------------------------------*/
/* Private defines -----------------------------------------------------------*/
#define BUFFERSIZE     ((uint16_t)1*8192)  
/* Private macros ------------------------------------------------------------*/
/* Private variables ---------------------------------------------------------*/

uint8_t RAMBuf[BUFFERSIZE] = { 0x00 };

static uint32_t LastPGAddress = APPLICATION_ADDRESS;
static uint32_t updateFileSize = 0;
/* Private function prototypes -----------------------------------------------*/
/* Private functions ---------------------------------------------------------*/

/**
 * @brief IAP Read all flash memory
 * @param  None
 * @retval None
 */
void COMMAND_UPLOAD(void) {
	__IO uint32_t address = FLASH_BASE;
	__IO uint32_t counter_read = 0x00;
	uint32_t tmp_counter = 0x00, index_offset = 0x00;

	/* Init written byte counter */
	index_offset = 0x00;

	/* Read flash memory */
	while (index_offset != FLASH_SIZE) {
		for (counter_read = 0; counter_read < BUFFERSIZE; counter_read++) {
			/* Check the read bytes versus the end of flash */
			if (index_offset + counter_read != FLASH_SIZE) {
				tmp_counter = counter_read;
				RAMBuf[tmp_counter] = (*(uint8_t*) (address++));
			}
			/* In this case all flash was read */
			else {
				break;
			}
		}

		/* Write buffer to file */
		f_write(&SDFile, RAMBuf, counter_read, (UINT*) &tmp_counter);

		/* Number of bytes written  */
		index_offset = index_offset + counter_read;
	}

	/* Close file and filesystem */
	f_close(&SDFile);

}

/**
 * @brief  IAP write memory
 * @param  None
 * @retval None
 */
uint32_t COMMAND_DOWNLOAD(void) {
	FILINFO finfno = { 0 };

	if (f_stat(DownloadFile, &finfno) != FR_OK) {
		/* 'STM32.TXT' file Open for write Error */
		return DOWNLOAD_FILE_FAIL;
	}

	updateFileSize = finfno.fsize;
	if (finfno.fsize < (FLASH_SIZE - IAP_SIZE)) {
		/* Erase necessary page to download image */
		if (FLASH_If_Erase(APPLICATION_ADDRESS) != 0) {
			return DOWNLOAD_ERASE_FAIL;
		}

		/* Program flash memory */
		return COMMAND_ProgramFlashMemory();
	}
	return DOWNLOAD_OK;
}

/**
 * @brief  IAP jump to user program
 * @param  None
 * @retval None
 */
void COMMAND_JUMP(void) {
	/* Software reset */
	NVIC_SystemReset();
}

/**
 * @brief  COMMAND_ProgramFlashMemory
 * @param  None
 * @retval DOWNLOAD_OK: Download process completed
 * @retval DOWNLOAD_FILE_FAIL: not possible to read from opend file
 * @retval DOWNLOAD_WRITE_FAIL: not possible to write to FLASH
 */
uint32_t COMMAND_ProgramFlashMemory(void) {
	__IO uint32_t read_size = 0x00, tmp_read_size = 0x00;
	uint32_t read_flag = TRUE;
	float update_speed = 0.0;

	/* Erase address init */
	LastPGAddress = APPLICATION_ADDRESS;

	/* While file still contain data */
	while (read_flag == TRUE) {

		/* Read maximum "BUFFERSIZE" Kbyte from the selected file  */
		if (f_read(&SDFile, RAMBuf, BUFFERSIZE, (UINT*) &read_size)
				!= FR_OK) {
			return DOWNLOAD_FILE_FAIL;
		}

		/* Temp variable */
		tmp_read_size = read_size;

		/* The read data < "BUFFERSIZE" Kbyte */
		if (tmp_read_size < BUFFERSIZE) {
			read_flag = FALSE;
		}
		
		/* display update progrees bar */
		update_speed = LastPGAddress - APPLICATION_ADDRESS;
		update_speed /= updateFileSize;
		LCD_DrawRectangle(0, 200, update_speed*LCD_DEFAULT_WIDTH, 20, GREEN, 1);
		Serial_PutString(">>");
		
		/* Program flash memory */
		if (FLASH_If_Write(LastPGAddress, (uint32_t*) RAMBuf, read_size/4)
				!= FLASHIF_OK) {
			return DOWNLOAD_WRITE_FAIL;
		}

		/* Update last programmed address value */
		LastPGAddress = LastPGAddress + tmp_read_size;
	}

	return DOWNLOAD_OK;
}

/**
 * @}
 */

/*******************(C)COPYRIGHT STMicroelectronics *****END OF FILE******/
