gotemcoach86/Geeetech-Spark-E3/(commit log)

2023-05-05 Geeetech Spark E3 Open source materials.
    [Configuration.h, Configuration_adv.h, esp32.csv]
2023-09-20 Update Kilpper related files
    [Geeetech_SPARK_E3_Config.txt]
2023-11-15 Fix pin documentation and manual errors
2023-11-15 Optimize the klipper configuration file.
    Added the TMC220X serial port mode and proximity sensor leveling mode to the klipper configuration file .
    [Geeetech_SPARK_E3_Klipper_Config.txt]
