gotemcoach86/Geeetech-Spark-E3/(notices)

Notices in the files:
Firmware/Marlin/SparkE3_V1.0_230428_3Dtouch/SRC/Marlin-SparkE3-LcdTFT-TMC2209/Marlin/src/core/boards.h:
This program is free software: you can redistribute it and/or modify
it under the terms of the GNU General Public License as published by
the Free Software Foundation, either version 3 of the License, or
(at your option) any later version.
Firmware/Marlin/SparkE3_V1.0_230428_3Dtouch/SRC/Bootloader/Inc/ffconf.h:
© Copyright (c) 2020 STMicroelectronics.
All rights reserved.
Firmware/Marlin/SparkE3_V1.0_230428_3Dtouch/SRC/Bootloader/Src/main.c:
This software component is licensed by ST under BSD 3-Clause license,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
Firmware/Marlin/SparkE3_V1.0_230428/SRC/Marlin-SparkE3-LcdTFT-TMC2209/Marlin/Configuration_adv.h:
define TOUCH_UI_UTF8_COPYRIGHT // © ®
Firmware/Marlin/SparkE3_V1.0_230428_3Dtouch/SRC/Bootloader/Src/bsp_lcd.c:
(C) COPYRIGHT 2015-2020 Ó²Ê¯Ç¶ÈëÊ½¿ª·¢ÍÅ¶Ó *****END OF FILE
